develtechmon/Ardupilot_ESP2/ESP32_DEVKIT_V1/Official/ESP32_GY91_Ardupilot_Coreless_Motor/Schematic_Diagram.png

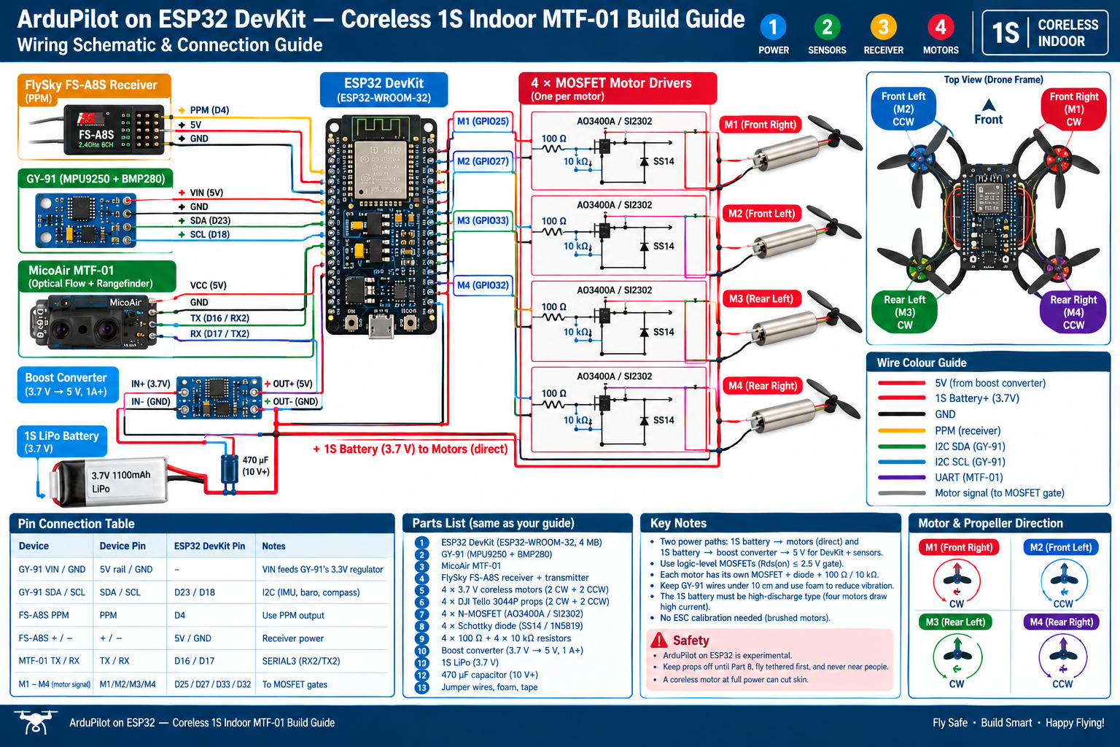
ESP32_DEVKIT_V1/Official/ESP32_GY91_Ardupilot_Coreless_Motor/Schematic_Diagram.png
