develtechmon/Ardupilot_ESP2/ESP32_WEMOS_D1/Official/ESP32_GY91_Ardupilot_Brushless_Motor/Schematic_Diagram.png

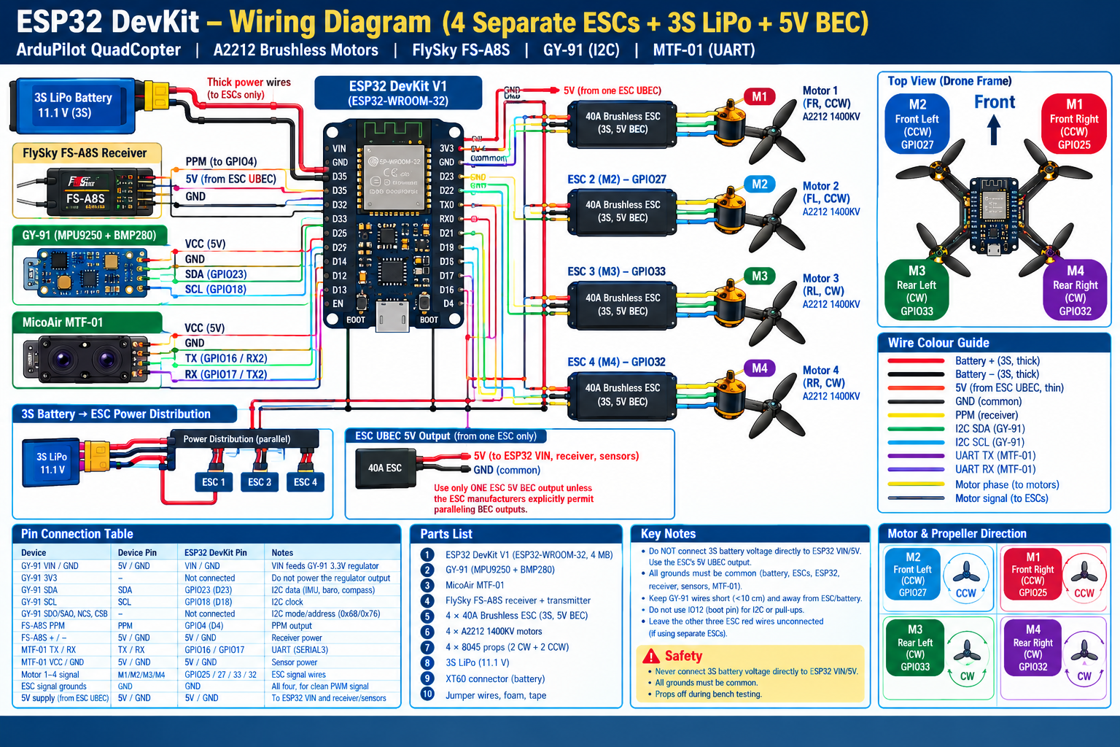
ESP32_WEMOS_D1/Official/ESP32_GY91_Ardupilot_Brushless_Motor/Schematic_Diagram.png
