develtechmon/Ardupilot_ESP2/ESP32_Ardupilot_Bottom_v1.stl

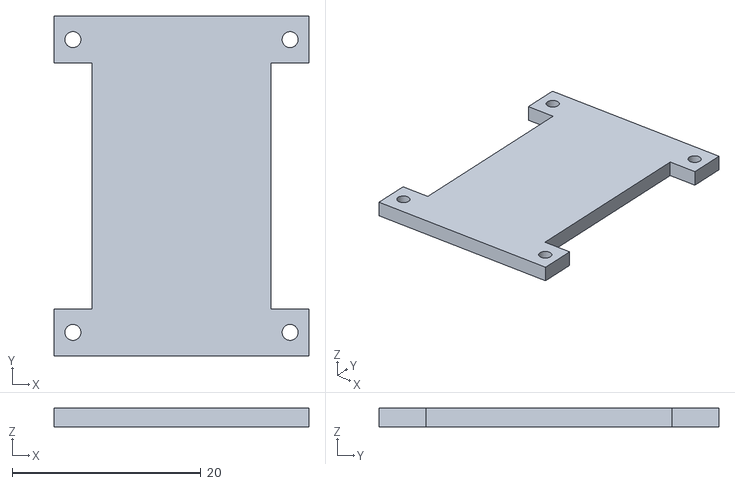
[picture p3: CAD file, 2026-10-27]
ESP32_Ardupilot_Bottom_v1.stl
27.0 x 36.0 x 2.00
