develtechmon/Ardupilot_ESP2/ESP32_Ardupilot_Top.stl

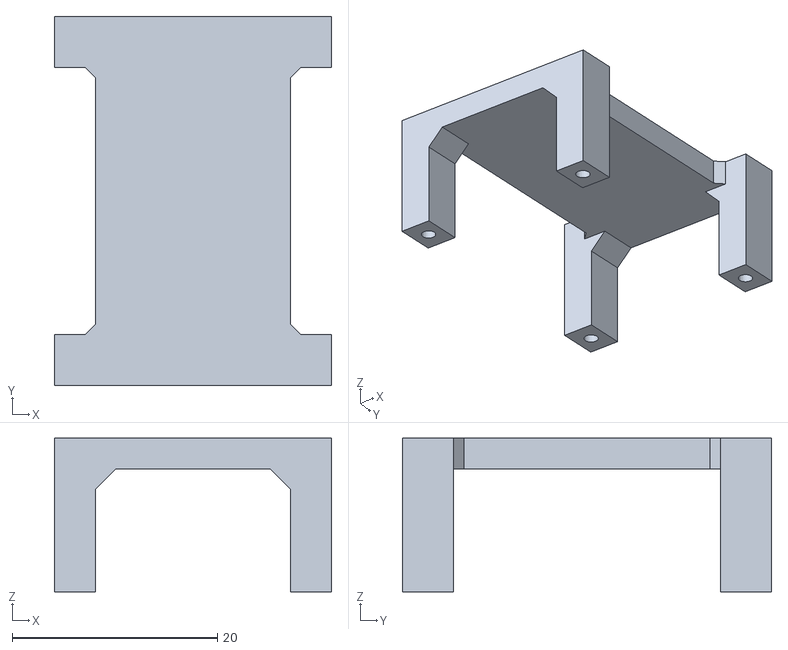
[picture p5: CAD file, 2026-10-27]
ESP32_Ardupilot_Top.stl
27.0 x 36.0 x 15.0
