develtechmon/Ardupilot_ESP2/ESP32_WEMOS_D1/Reference/Ardupilot_on_ESP32_MPU6050_Indoor_MTF-01_Guide_build.md

# ArduPilot on ESP32 + MPU6050 — Indoor MTF-01 Build Guide

Oct 12, 2026 · @lukas

This guide builds an indoor ArduCopter flight controller from a WEMOS D1 Mini ESP32 (MINI32), an MPU6050 IMU on I2C and a MicoAir MTF-01 optical-flow and range sensor. It replaces the GY-91 with the MPU6050, keeps every fix found on the GY-91 build, and adds a noise test so you can prove the IMU is good before it flies.

## At a glance

> **Status and safety.** ArduPilot on ESP32 is experimental. Keep props **off** until Part 8, fly tethered first, and never near people. Tested with ArduPilot master (`ArduCopter V4.8.0-dev`, commit `81ff4d6a`, 6 October 2026) and ESP-IDF 5.3: the `esp32lukas6050` board in this guide was built from that source, and every parameter in its `defaults.parm` was checked against ArduCopter's parameter list. It has not been flown on hardware yet; Part 2 and Part 8 are how you prove it.

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

**What changes from the GY-91 build:**

|  | GY-91 build (`esp32lukas`) | This build (`esp32lukas6050`) |
| --- | --- | --- |
| IMU | MPU9250 on SPI (IO18/19/23, CS IO5) | **MPU6050 on I2C** (SDA IO21, SCL IO22), address 0x68 |
| Barometer | BMP280 inside the GY-91 (SPI, CS IO26) | Optional BMP280 module on the same I2C bus (0x76) |
| Compass | AK8963 inside the GY-91 | **None** (`COMPASS_ENABLE 0`, `EK3_SRC1_YAW 0`); an external I2C compass is optional |
| I2C pins | IO13/IO12 (unused, because the GY-91 ran on SPI) | **IO21/IO22**. IO12 is a boot pin and would stop the ESP32 booting with an I2C pull-up on it |
| Motor outputs | IO25, 27, 33, 32 + IO22, 21 spare | IO25, 27, 33, 32 (IO21/22 now belong to I2C) |
| Everything else | MTF-01 on SERIAL3, PPM on IO4, WiFi, `SCHED_LOOP_RATE 150` | Same |

**Fixes carried over from the GY-91 build** (all needed, all in Part 4):

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

## Part 1: Parts and wiring

### 1.1 Parts

| Part | Notes |
| --- | --- |
| WEMOS D1 Mini ESP32 (MINI32) | Classic ESP32 (ESP32-WROOM-32, 4 MB flash). A classic ESP32 DevKit works with the same pins |
| MPU6050 module (GY-521) | I2C, address 0x68. Has its own 3.3V regulator and I2C pull-up resistors |
| BMP280 module (optional) | I2C, address 0x76. Many are 3.3V-only. Without it, height comes from the MTF-01 only |
| MicoAir MTF-01 | Optical flow + rangefinder, MAVLink on a UART |
| FlySky FS-A8S receiver + transmitter | PPM output |
| 4 × brushless ESC (40A, 5V BEC) + A2212 1400KV + 8045 props | Plain PWM ESCs; calibrated with the sketch in Part 7 |
| 3S LiPo | 11.1V nominal |
| Short jumper wires, soft foam tape | Keep the IMU wires under about 10 cm |

### 1.2 Pin table

| Device pin | MINI32 pin | Notes |
| --- | --- | --- |
| MPU6050 SDA | IO21 | I2C data |
| MPU6050 SCL | IO22 | I2C clock |
| MPU6050 VCC / GND | 5V / GND | The GY-521's own regulator makes 3.3V, and its pull-ups go to that 3.3V |
| MPU6050 AD0 | GND (or unconnected) | Low = address 0x68 |
| MPU6050 INT, XDA, XCL | not connected |  |
| BMP280 SDA / SCL | IO21 / IO22 | Same bus as the MPU6050 |
| BMP280 VCC / GND | 3V3 / GND | 3.3V unless the module has a regulator |
| BMP280 SDO / CSB | GND / 3V3 | SDO low = address 0x76; CSB high = I2C mode |
| FS-A8S PPM | IO4 | Use the PPM output |
| FS-A8S + / − | 5V / GND |  |
| MTF-01 TX | IO16 | MINI32 RX, ArduPilot SERIAL3 |
| MTF-01 RX | IO17 | MINI32 TX |
| MTF-01 VCC / GND | 5V / GND |  |
| Motor 1–4 signal | IO25, IO27, IO33, IO32 | ESC signal wires |
| ESC signal grounds | GND | All four, for a clean PWM signal |
| 5V supply | 5V / GND | One ESC's BEC (red + black). Leave the other three ESCs' red wires unconnected |

### 1.3 Wiring rules

- **Never put I2C (or anything with a pull-up) on IO12.** IO12 is an ESP32 boot pin: pulled high at power-up, it sets the flash to 1.8V and the board won't boot. Also leave IO6–IO11 alone (internal flash).
- **Keep the IMU wires short** (under about 10 cm) and route them away from the ESC and battery wires. Twist SDA and SCL each with a GND wire if they must be longer.
- **USB and the BEC together:** the MINI32's 5V pin connects straight to USB 5V. During bench setup, unplug the BEC's red wire while USB is connected, or power the board from USB only.
- **Mount the MPU6050 so ArduPilot reads it the right way.** ArduPilot's driver maps the chip's Y axis to the drone's forward direction (`AP_InertialSensor_Invensense.cpp`, lines 613–615). With `ROTATION_NONE`: **chip side up, the board's printed Y arrow pointing forward, the X arrow pointing right**. Mount it flat, near the centre of the frame, on firm foam that doesn't let it rock.
- **Mount the MTF-01** underneath, lens straight down, square to the frame, with a clear view of the floor (its camera sees a 42° cone). Part 6 checks its orientation.

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

## Part 2: Test the IMU before you build (MPU6050 and GY-91)

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

```cpp
// IMU check for ArduPilot on ESP32: I2C scan, chip ID, and a still-noise test.
// Works for the MPU6050 (GY-521) and for the GY-91's MPU9250 wired in I2C mode.
// Wiring: SDA = IO21, SCL = IO22. Board on a folded towel, don't touch it.
#include <Wire.h>

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

void setup() {
  Serial.begin(115200);
  delay(1000);
  Wire.begin(21, 22, 400000);                              // SDA, SCL, 400 kHz like ArduPilot

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

void loop() {
  double s[6] = {0}, q[6] = {0};
  int good = 0;
  for (int i = 0; i < N; i++) {
    uint8_t b[14];
    if (readRegs(0x3B, b, 14)) {                           // accel x,y,z, temperature, gyro x,y,z
      int16_t r[7];
      for (int k = 0; k < 7; k++) r[k] = (int16_t)((b[2 * k] << 8) | b[2 * k + 1]);
      double v[6] = { r[0] / 16.384, r[1] / 16.384, r[2] / 16.384,     // accel in milli-g
                      r[4] / 131.0,  r[5] / 131.0,  r[6] / 131.0 };   // gyro in deg/s
      for (int k = 0; k < 6; k++) { s[k] += v[k]; q[k] += v[k] * v[k]; }
      good++;
    }
    delay(5);
  }
  if (good < N / 2) {
    Serial.printf("Only %d/%d reads worked: check the wiring\n", good, N);
    delay(3000);
    return;
  }
  double m[6], sd[6];
  for (int k = 0; k < 6; k++) {
    m[k] = s[k] / good;
    sd[k] = sqrt(fmax(0.0, q[k] / good - m[k] * m[k]));
  }
  double accN = fmax(sd[0], sd[1]);
  double gyrN = fmax(fmax(sd[3], sd[4]), sd[5]);
  Serial.printf("\nreads OK %d/%d\n", good, N);
  Serial.printf("ACC  mean x %7.1f y %7.1f z %7.1f mg    noise x %5.2f y %5.2f z %5.2f mg\n",
                m[0], m[1], m[2], sd[0], sd[1], sd[2]);
  Serial.printf("GYRO mean x %6.2f y %6.2f z %6.2f dps   noise x %5.3f y %5.3f z %5.3f dps\n",
                m[3], m[4], m[5], sd[3], sd[4], sd[5]);
  Serial.printf("ACC noise %s   GYRO noise %s\n",
                accN <= 5 ? "GOOD" : accN <= 10 ? "OK" : "BAD",
                gyrN <= 0.15 ? "GOOD" : gyrN <= 0.3 ? "OK" : "BAD");
  delay(2000);
}
```

**Wiring for the test:**

|  | MPU6050 (GY-521) | GY-91 in I2C mode |
| --- | --- | --- |
| SDA / SCL | IO21 / IO22 | SDA / SCL to IO21 / IO22 |
| Power | VCC to 5V, GND | VIN to 3V3 (or 5V), GND; leave its 3V3 pin unconnected |
| Address pin | AD0 to GND | SDO/SAO to GND |
| Mode pins | — | NCS to 3V3 and CSB to 3V3 (high = I2C mode for both chips) |

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

**Run it three times, then read the result:**

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

## Part 3: Build environment (once)

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

**3.1 System packages**

```bash
sudo apt update

sudo apt install -y git wget flex bison gperf cmake ninja-build ccache \
  libffi-dev libssl-dev dfu-util libusb-1.0-0 python3 python3-pip python3-venv
```

**3.2 Clone ArduPilot**

```bash
mkdir -p ~/ardupilot_esp32_build && cd ~/ardupilot_esp32_build

git clone --recursive https://github.com/ArduPilot/ardupilot.git    # several GB

cd ardupilot

git submodule status | grep -E '^[-+U]'             # must print nothing

Tools/environment_install/install-prereqs-ubuntu.sh -y
```

Then **close the terminal and open a new one**, so the new PATH loads.

**3.3 Fetch ESP-IDF 5.3**

```bash
cd ~/ardupilot_esp32_build/ardupilot

./Tools/scripts/esp32_get_idf.sh

git -C modules/esp_idf describe --tags               # must show v5.3.x

git -C modules/esp_idf submodule status --recursive | grep -E '^[-+U]'   # must print nothing
```

**3.4 Create the ESP-IDF Python environment** (in a fresh terminal)

```bash
which python3                                        # must be /usr/bin/python3

echo "VIRTUAL_ENV=$VIRTUAL_ENV"                      # must be empty

cd ~/ardupilot_esp32_build/ardupilot

./modules/esp_idf/install.sh                         # ends with "All done!"
```

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

```bash
alias get_idf='source ~/ardupilot_esp32_build/ardupilot/modules/esp_idf/export.sh'
```

Then, once:

```bash
cd ~/ardupilot_esp32_build/ardupilot

get_idf                                              # load the tools

python3 -m pip install empy==3.3.4 pexpect           # once per environment
```

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

## Part 4: Board files and the ESP32 fixes

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

### 4.1 Create the board folder and `hwdef.dat`

Change `WIFI_SSID` and `WIFI_PWD` (8+ characters) before you run it.

```bash
cd ~/ardupilot_esp32_build/ardupilot

mkdir -p libraries/AP_HAL_ESP32/hwdef/esp32lukas6050

cat > libraries/AP_HAL_ESP32/hwdef/esp32lukas6050/hwdef.dat <<'EOF'
# esp32lukas6050: WEMOS D1 Mini ESP32 (or DevKit) + MPU6050 (GY-521) on I2C, indoor MTF-01 build
define HAL_ESP32_BOARD_NAME "esp32-lukas-6050"

# --- I2C bus 0 on the standard ESP32 I2C pins (NOT IO12: it is a boot strapping pin)
#             Port       SDA         SCL          SPEED    INTERNAL SOFT
ESP32_I2CBUS  I2C_NUM_0  GPIO_NUM_21 GPIO_NUM_22  400*KHZ  false    false

# --- IMU: MPU6050 at I2C address 0x68 (AD0 low)
define HAL_INS_DEFAULT HAL_INS_MPU60XX_I2C
IMU Invensense I2C:0:0x68 ROTATION_NONE
define INS_MAX_INSTANCES 3

# --- Barometer: BMP280 module at 0x76 (SDO to GND); boots fine without it
BARO BMP280 I2C:0:0x76
define HAL_BARO_ALLOW_INIT_NO_BARO 1

# --- Compass: none on the MPU6050; an external I2C compass on the same bus is found by probing
define AP_COMPASS_PROBING_ENABLED 1

# --- no airspeed sensor
define AP_AIRSPEED_ENABLED 0

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

# --- motor outputs 1-4
ESP32_RCOUT GPIO_NUM_25
ESP32_RCOUT GPIO_NUM_27
ESP32_RCOUT GPIO_NUM_33
ESP32_RCOUT GPIO_NUM_32

# --- RC input (PPM) on IO4
define HAL_ESP32_RCIN GPIO_NUM_4
define HAL_ESP32_RMT_RX_PIN_NUMBER 4

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

# --- optical flow (MTF-01): needs the esp32.h fix (4.3)
define AP_OPTICALFLOW_ENABLED 1
EOF
```

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

### 4.2 Create `defaults.parm`

```bash
cat > ~/ardupilot_esp32_build/ardupilot/libraries/AP_HAL_ESP32/hwdef/esp32lukas6050/defaults.parm <<'EOF'
# esp32lukas6050 defaults (MPU6050 + MTF-01, indoor). Applied to every never-saved parameter.

# --- loop rate: the ESP32 cannot run 400 Hz
SCHED_LOOP_RATE 150

# --- frame: quad X, plain PWM ESCs
FRAME_CLASS 1
FRAME_TYPE 1
MOT_PWM_TYPE 0
MOT_PWM_MIN 1000
MOT_PWM_MAX 2000

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

# --- channel 6 = arm (up) / disarm (down); after boot flip it down, then up
RC6_OPTION 153

# --- never start ESC calibration from ArduPilot: it hangs the ESP32 (calibrate with the sketch)
ESC_CALIBRATION 9

# --- logging off: no SD card on the MINI32 (set 1 once you fit one)
LOG_BACKEND_TYPE 0

# --- failsafes
FS_THR_ENABLE 3
FS_THR_VALUE 975
FS_GCS_ENABLE 0
FS_EKF_ACTION 1

# --- no compass on the MPU6050 (set COMPASS_ENABLE 1 and EK3_SRC1_YAW 1 if you add one)
COMPASS_ENABLE 0

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

# --- EKF3 sources for INDOOR flight: flow velocity, rangefinder height, no yaw source
EK3_SRC_OPTIONS 0
EK3_SRC1_POSXY 0
EK3_SRC1_VELXY 5
EK3_SRC1_POSZ 2
EK3_SRC1_VELZ 0
EK3_SRC1_YAW 0
EOF
```

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

### 4.3 Fix 1: turn optical flow back on

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

```bash
cd ~/ardupilot_esp32_build/ardupilot

F=libraries/AP_HAL/board/esp32.h

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

grep -n -B1 -A1 "AP_OPTICALFLOW_ENABLED" $F
```

**Check:** three lines in a row: `#ifndef AP_OPTICALFLOW_ENABLED`, `#define AP_OPTICALFLOW_ENABLED 0`, `#endif`.

### 4.4 Fix 2: motors stuck at idle

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

```bash
cd ~/ardupilot_esp32_build/ardupilot

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

grep -n "#if\|#else\|no ESC telemetry" ArduCopter/takeoff_check.cpp
```

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

### 4.5 Fix 3: ESC calibration

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

### 4.6 Check the parameter names

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

```bash
cd ~/ardupilot_esp32_build/ardupilot/Tools/autotest/param_metadata

python3 param_parse.py --vehicle ArduCopter --format json > /dev/null   # creates apm.pdef.json

cd ~/ardupilot_esp32_build/ardupilot

python3 - <<'EOF'
import json
d = json.load(open('Tools/autotest/param_metadata/apm.pdef.json'))
names = {k for grp in d.values() for k in grp}
bad = [l.split()[0] for l in open('libraries/AP_HAL_ESP32/hwdef/esp32lukas6050/defaults.parm')
       if l.split('#')[0].strip() and l.split()[0] not in names]
print("Unknown parameters:", bad if bad else "none")
EOF
```

**Check:** it prints `Unknown parameters: none`.

## Part 5: Build, check and flash

### 5.1 Build

```bash
cd ~/ardupilot_esp32_build/ardupilot

get_idf                                       # load the ESP32 tools

./waf configure --board=esp32lukas6050        # choose this board

./waf copter                                  # build ArduCopter (about 10 minutes the first time)
```

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

### 5.2 Confirm the IMU, flow, throttle fix and defaults are inside

Do this before every flash that follows a board-file or source change.

```bash
cd ~/ardupilot_esp32_build/ardupilot

grep "HAL_INS_PROBE1" build/esp32lukas6050/hwdef.h                                    # MPU6050 on I2C bus 0, 0x68

nm -C build/esp32lukas6050/esp-idf_build/ardupilot.elf | grep -c AP_OpticalFlow_MAV   # above 0: flow driver in

nm -C -S build/esp32lukas6050/esp-idf_build/ardupilot.elf | grep " Copter::takeoff_check()"   # size NOT 00000005

grep -c "defaults.parm" build/esp32lukas6050/ap_romfs_embedded.h                      # 1: defaults embedded
```

**Check:**

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

### 5.3 Flash

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

**On Windows with WSL2**, first pass the USB port to Ubuntu. In an **Admin PowerShell**:

```powershell
winget install --interactive --exact dorssel.usbipd-win   # once; then reopen PowerShell

usbipd list                                               # find the board (CP2104 = 10c4:ea60); note its BUSID, e.g. 1-1

usbipd bind --busid 1-1                                   # once per board

usbipd attach --wsl --busid 1-1                           # every time you plug it in; keep Ubuntu open
```

Then in **Ubuntu**:

```bash
ls /dev/ttyUSB* /dev/ttyACM* 2>/dev/null                  # find the port, e.g. /dev/ttyUSB0

sudo usermod -aG dialout $USER                            # once; then log out and back in

cd ~/ardupilot_esp32_build/ardupilot

get_idf

esptool.py --chip esp32 -p /dev/ttyUSB0 erase_flash       # first flash of this board only

ESPPORT=/dev/ttyUSB0 ESPBAUD=921600 ./waf copter --upload
```

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

```bash
cd ~/ardupilot_esp32_build/ardupilot/build/esp32lukas6050/esp-idf_build

esptool.py --chip esp32 -p /dev/ttyUSB0 --before no_reset erase_flash

# press and release RST again (jumper still in), then:
esptool.py --chip esp32 -p /dev/ttyUSB0 --before no_reset -b 460800 write_flash @flash_args
```

Remove the jumper and press RST to start the firmware.

### 5.4 Check that it boots

```bash
python3 -m serial.tools.miniterm /dev/ttyUSB0 115200      # quit with Ctrl+]
```

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

**Check:** the log stops resetting, and after you connect Mission Planner (Part 6) the Messages tab shows no `INS: unable to initialise driver`. If you see that message, the MPU6050 wasn't found at 0x68: rerun the Part 2 sketch.

## Part 6: Mission Planner setup and calibration

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

### 6.1 Connect

- **USB (best for setup):** pick the board's COM port and **115200** (not AUTO). In **Config → Planner**, tick only **Reset on USB connect (DTR)**; untick it too if connecting is slow.
- **WiFi (good for watching values during tests):** join your `WIFI_SSID` network, then connect with **TCP**, host **192.168.4.1**, port **5760**.

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

### 6.2 Set the parameters that need a reboot first

In **Config → Full Parameter List**, set and **Write Params**, then reboot:

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

### 6.3 Calibrate

In **Setup → Mandatory Hardware**, over USB:

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

Skip **Compass**: there is none on this build (6.6). Skip **ESC Calibration**: Part 7.

### 6.4 Check the IMU inside ArduPilot

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

Put the frame on a level table, USB only, and watch for 5 minutes:

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

### 6.5 MTF-01 checks

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

**Data check** (hold the drone 30–50 cm over a textured floor, in normal room light):

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

### 6.6 Heading without a compass

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

**Adding an external compass later** (QMC5883L or HMC5883L on IO21/IO22, mounted away from power wires): set `COMPASS_ENABLE 1` and `EK3_SRC1_YAW 1`, reboot, check it's detected, calibrate it in **Setup → Compass** away from steel, then check the HUD heading against a phone at N, E, S, W (within about 15°).

## Part 7: ESC calibration

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

```cpp
// GUIDED ESC CALIBRATION for 4 ESCs - no ArduPilot. PROPS OFF.
// To start over: unplug the battery, press the ESP32's EN/RST button.

const int ESC_PINS[4] = {25, 27, 33, 32};   // motor 1-4 pins from the board file

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

void loop() {
  // nothing - the signal stays at 1000 us (motors stopped)
}
```

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

**ESC beep codes** (generic plane-style 40A ESCs):

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

## Part 8: Bench test, then indoor flight in stages

### 8.1 Bench test (props OFF)

Work through every item; fix any failure before moving on.

- [ ] Boot log stops resetting; Messages show no `INS: unable to initialise driver` (and the BMP280, if fitted, is found)
- [ ] IMU still check passes (6.4): HUD steady within about ±1°
- [ ] Radio bars correct (6.3); CH5 switches Stabilize / AltHold
- [ ] Transmitter off → Mission Planner reports a radio failsafe
- [ ] MTF-01 data, tilt test and move test pass (6.5)
- [ ] **Motor Test** (Setup → Optional Hardware) at 10%: A = front-right, B = rear-right, C = rear-left, D = front-left, each spinning the way the Part 1 motor table says (swap any two of a motor's three wires to reverse it)
- [ ] **Arm:** after boot, flip CH6 **down, then up**. HUD shows **ARMED**, and **Data → Status** shows `ch1out` to `ch4out` at about **1100** with the stick down
- [ ] **Throttle:** push the stick up slowly. `ch1out` to `ch4out` rise **together** toward about 1900 and the motors speed up
- [ ] **Stabilisation:** at about 30% throttle, tilt the frame by hand; the motors on the low side speed up
- [ ] **Disarm:** CH6 down stops the motors at once

What the output numbers mean when you think it's armed:

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

### 8.2 Props on

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

### 8.3 Fly in stages

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

## Troubleshooting

| Symptom | Cause | Fix |
| --- | --- | --- |
| Board won't boot, or boot-loops right after wiring the IMU | Something with a pull-up on IO12 (boot pin) | Move it to IO21/IO22 as in Part 1; keep IO12 free |
| `INS: unable to initialise driver` | MPU6050 not found at 0x68 | Run the Part 2 sketch: check the I2C scan shows 0x68 and `WHO_AM_I` is 0x68; check SDA/SCL aren't swapped and AD0 is low |
| `WHO_AM_I` is not 0x68 / 0x70 / 0x71 / 0x73 | A clone ArduPilot's Invensense driver doesn't recognise | Use a different module |
| HUD rocks or drifts while sitting still | Noisy chip, soft or loose mount, long wires, or moved during power-up | Part 2 sketch on a towel first; then firm mount, short wires, power up still; redo Calibrate Level |
| `PreArm: Rangefinder 1: No Data`; ground speed and height wander while still | The EKF has lost the MTF-01 (it is its height and velocity source) | Check MTF-01 wiring (TX → IO16, RX → IO17), MicoAssistant settings, `SERIAL3_PROTOCOL 1`, `SERIAL3_BAUD 115`, `MAV3_OPTIONS 2`. For bench tests without it: `EK3_SRC1_POSZ 1`, `EK3_SRC1_VELXY 0` |
| `FLOW_TYPE` missing from the parameter list | Flow compiled out | Do 4.3, configure and build again, check 5.2 |
| Armed, motors idle, throttle does nothing; `ch1out`–`ch4out` stay at 1150 | Motors-stuck-at-idle bug | Do 4.4, rebuild, check the `takeoff_check` size (5.2), flash |
| `ch1out`–`ch4out` stay at 1000 while you think it's armed | Not armed | HUD must say ARMED; flip CH6 down then up; `ch6in` must pass 1200 and 1800 |
| Board stopped answering Mission Planner after "Calibrate ESCs" | ESC calibration re-runs and hangs at every power-up | Wipe only the parameter storage: `esptool.py --chip esp32 -p /dev/ttyUSB0 erase_region 0x310000 0x40000` (IO0 to GND if it won't connect), then redo Part 6 and use Part 7 |
| ESC beeps once every 2 s | No PWM signal | Signal wire on the right pin; ESC signal ground to ESP32 GND |
| Motor Test works but motors stutter or ignore higher % | ESC can't follow 400 Hz | `RC_SPEED 50`, then step up (Part 7) |
| AltHold pumps up and down | Vibration, wrong hover throttle, or noisy rangefinder | `vibez` below about 15–20; hover longer so `MOT_THST_HOVER` learns; check `rangefinder1` |
| Loiter leans hard or flips | Flow orientation inverted, or a bad attitude or heading estimate | Back to AltHold; redo the tilt test (6.5); fix `FLOW_ORIENT_YAW`; get a log before trying again |
| `No MAVLink Heartbeat Packets` | Port held by another program, AUTO baud, or reset on connect | Close other serial programs; 115200 not AUTO; Config → Planner reset options (6.1) |
| Board resets when throttle goes up (`rst:0xf`) | 5V brownout | Stronger 5V supply, capacitor across 5V and GND |
| `waf` fails with `constraints ... doesn't exist` | ESP-IDF Python check | `export IDF_PYTHON_CHECK_CONSTRAINTS=no`, delete `build/esp32lukas6050/esp-idf_build`, build again |

## Sources

**ArduPilot pull requests (the motor-idle bug)**

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

**ArduPilot documentation**

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

**Forum threads**

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

**ArduPilot source files checked (master, October 2026)**

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

**Datasheets**

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
