develtechmon/Ardupilot_ESP2/ESP32_DEVKIT_V1/ESP32 DevKit Quadcopter Wiring Diagram.png

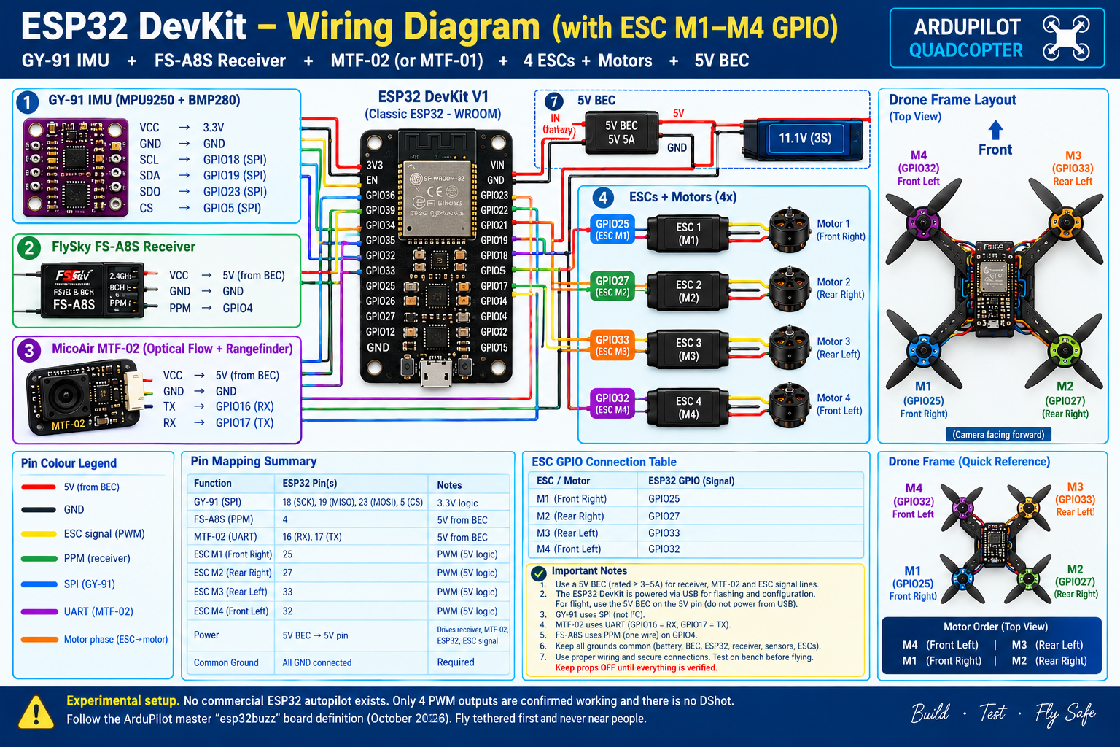
ESP32_DEVKIT_V1/ESP32 DevKit Quadcopter Wiring Diagram.png
