develtechmon/Ardupilot_ESP2/(commit log)

2026-10-08 Added Schematic
2026-10-27 +added 3d print
